dansoft-ch/KaRadio/KaRadio-Factsheet-FirmwareNG-BT.docx

KaRadio – Firmware NG mit Bluetooth („Biennophone“)

Factsheet · Stand 07.11.2026 · Branch firmware-ng-bt (v2) · Repository dansoft-ch/KaRadio · am Gerät getestet

So funktioniert das System

- Ein Board: Der ESP32 WROVER mit eigener KaRadio32-Firmware (Release 2.4 R1 plus stationkeys.c und btspeaker.c) liest Tasten und Potis selbst aus und ist zusätzlich Bluetooth-Lautsprecher. Kein ESP32-S3 nötig. Netzteil ≥ 1 A, besser 2 A, am USB-Port des WROVER.
- Sendertasten 1–6: Rasttasten gegen GND, interner Pull-up, 40 ms entprellt. Taste n spielt Sender n−1 (wie cli.play). Der Sender wird gespeichert und nach dem Einschalten wieder gespielt.
- Bluetooth: Immer an und für Handys als „Biennophone“ sichtbar (A2DP, Koppeln ohne PIN), auch während das Radio spielt. Spielt das Handy, stoppt das Radio und nach ca. 1 s kommt der Handy-Ton. Pause länger als 15 s oder Handy getrennt: der letzte Sender spielt wieder. Eine Sendertaste trennt das Handy und spielt den Sender. WLAN bleibt an.
- Lautstärke-Poti: Stellt die Lautstärke 0–254 ein, bei Radio und Bluetooth. In den ersten 60 s nach dem Start gilt immer das Poti, danach ändert sich die Lautstärke nur beim Drehen.
- Ein/Aus-Knopf: Der Schalter steuert ein Reed-Relais (hartes Ein/Aus, ohne Firmware). Der Schleifer des Potis steuert Mute nach der Drehrichtung: ca. 10 % aufdrehen = Mute aus, ca. 10 % zudrehen = Mute an. Nach dem Einschalten ist Mute aus.
- Absturz und Start-Wächter: Nach einem Absturz startet der WROVER selbst neu. Ein Hardware-Watchdog startet neu, wenn KaRadio nicht innerhalb von 90 s „READY“ erreicht. WLAN: 3 Versuche, dann ein Neustart, erst danach AP-Modus.

Pinout ESP32 WROVER

GPIO | Bedienung | GPIO | Audio und System
GPIO 13 | Taste 1 → Sender 0 | GPIO 25 | MAX98357A LRC (grün)
GPIO 14 | Taste 2 → Sender 1 | GPIO 26 | MAX98357A BCLK (blau)
GPIO 27 | Taste 3 → Sender 2 | GPIO 22 | MAX98357A DIN (gelb)
GPIO 15 | Taste 4 → Sender 3 (Boot-Pin) | 5 V / GND | VIN (rot) / GND (schwarz)
GPIO 5 | Taste 5 → Sender 4 (Boot-Pin) | SPI 18/19/23, 32/33/34, 12 | VS1053 (nicht bestückt)
GPIO 2 | Taste 6 → Sender 5 (Boot-Pin) | GPIO 1 / 3 | USB (CH343): Flashen, Monitor
GPIO 39 (VN) | Lautstärke-Poti (Schleifer) | GPIO 35 | frei (nur Eingang, ADC1)
GPIO 36 (VP) | Mute-Poti (Schleifer) | GPIO 0 | BOOT-Taste, nicht verwenden
GPIO 21 | IR-Empfänger | GPIO 16, 17 | nicht verwenden (PSRAM)
GPIO 4 | Status-LED | – | Ein/Aus-Schalter → Reed-Relais

Hellblau = Tasten und Potis am WROVER. Mute-Poti an GPIO 36 (P_MUTE_POT = 36); ohne Poti braucht der Pin 100 kΩ nach 3,3 V oder P_MUTE_POT = 255. Potis: Enden an 3,3 V (nie 5 V) und GND, nur ADC1-Pins (32–39). Eingerastete Tasten beim Einschalten sind unkritisch; zum Flashen Taste 1 einrasten. Pins ändern ohne neue Firmware: standard_psram_dan_keys.csv anpassen (P_KEY0 … P_KEY5, P_VOL_POT, P_MUTE_POT; 255 = aus) und die .bin neu flashen.

Bauen und flashen

- Bauen: GitHub Actions baut bei jedem Push in firmware/ (ESP-IDF 3.3.6, Ka-Radio32 auf festem Commit + karadio.patch) und legt die .bin-Dateien in firmware/bin/ ab (holen mit git pull).
- Flashen: WROVER direkt an den PC (neues Board: Seriennummer 5C92044814, zuletzt COM3), dann firmware\flash.ps1 -Port COM3. Das Skript prüft die Seriennummer und bricht beim S3 ab. Sender, WLAN und Einstellungen bleiben erhalten.
- Adressen: 0x1000 bootloader.bin · 0x8000 partitions.bin · 0x10000 KaRadio32.bin · 0x3a2000 standard_psram_dan_keys.bin. otadata (0xd000) wird gelöscht. Neue Partitionstabelle: App-Partition 3,5 MB, dafür kein Web-Update (OTA) mehr.
- Test: Seriellen Monitor auf 115200 Baud. Beim Start: „btspeaker: sichtbar als Biennophone“ und „Start-Waechter aus (Neustart-Grund …)“. Handy spielt: „Bluetooth-Ton an“. Pause/Trennen/Sendertaste: „zurueck zum Radio“.
- Zurück: Ohne Bluetooth: Release firmware-ng-v1. Bluetooth über Taste 6 mit Neustart: Tag firmware-ng-bt-v1 (siehe VERSIONEN.md).

Grenzen

- Speicher: Bluetooth belegt intern fest rund 90 KB. Deshalb liegen WLAN- und Decoder-Puffer im PSRAM. Gemessen frei: Radio mit Bluetooth ca. 27 KB, Bluetooth-Ton ca. 32 KB, Radio mit verbundenem Handy ca. 18 KB.
- Ohne WLAN: KaRadio wartet beim Start auf das WLAN (oder geht in den AP-Modus). Erst danach sind Tasten, Potis und Bluetooth aktiv.
- Nur I2S: Bluetooth und Mute funktionieren nur mit I2S-Ausgang (MAX98357A), nicht mit VS1053.

Flashen mit dem Flash Download Tool

Espressif „Flash Download Tool“ (Windows) · gleiche Wirkung wie firmware\flash.ps1 · Dateien aus firmware\bin (nach git pull) oder aus einem Tag

Dateien und Adressen

Adresse | Datei | Inhalt
0x1000 | bootloader.bin | Bootloader (mit Start-Wächter)
0x8000 | partitions.bin | Partitionstabelle (App 3,5 MB, ohne OTA)
0xd000 | otadata_blank.bin | leert „otadata“, damit sicher die neue Firmware startet (8 KB, nur FF)
0x10000 | KaRadio32.bin | Firmware (KaRadio32 + Tasten, Potis, Bluetooth)
0x3a2000 | standard_psram_dan_keys.bin | Hardware-Konfiguration (Pins, aus der .csv)

Alle fünf Zeilen anhaken. Nur die Konfiguration geändert (z. B. Pins in der .csv)? Dann genügt die letzte Zeile. Nur die Firmware geändert? Dann genügen 0x10000 und 0xd000.

- Achtung 0x1D0000: Beim Original-KaRadio wurde KaRadio32.bin zusätzlich an 0x1D0000 geflasht (zweite App-Partition ota_1). Diese Zeile abwählen! Unsere App-Partition reicht von 0x10000 bis 0x390000; eine Datei an 0x1D0000 überschreibt mitten in der Firmware.

Einstellungen im Tool

- Start: ChipType ESP32, WorkMode Develop, LoadMode UART.
- SPI: SPI SPEED 40 MHz, SPI MODE DIO, „DoNotChgBin“ angehakt (Standard), damit das Tool den Kopf des Bootloaders nicht verändert.
- Port: COM-Port des WROVER (CH343, Seriennummer 5C92044814), BAUD 460800 oder 921600. Vorher in der Geräteverwaltung prüfen, dass nicht der ESP32-S3 (5CE5194172) dranhängt.
- ERASE: Löscht den ganzen Flash, also auch WLAN-Daten, Senderliste und Einstellungen. Nur für eine saubere Neuinstallation: zuerst ERASE, dann START mit allen Zeilen (otadata_blank.bin ist dann nicht nötig). Danach Gerät neu einrichten (AP „WifiKaRadio“, http://192.168.4.1). Einstellungen behalten: kein ERASE, dafür otadata_blank.bin an 0xd000.

Ablauf

- 1: WROVER direkt per USB an den PC; serieller Monitor (Arduino IDE) muss geschlossen sein. Zum Flashen Taste 1 einrasten.
- 2: Dateien und Adressen wie oben eintragen und anhaken, Einstellungen setzen.
- 3: START drücken. Das Tool setzt den WROVER selbst in den Flash-Modus. Klappt das nicht: BOOT-Taste halten, EN kurz drücken, BOOT loslassen.
- 4: Nach „FINISH“ startet der WROVER nicht automatisch neu: EN-Taste drücken oder kurz vom Strom trennen.
- 5: Test: serieller Monitor mit 115200 Baud. Erwartet: „btspeaker: sichtbar als Biennophone“, „READY“, danach spielt der letzte Sender.

Frühere Versionen

- Ohne Bluetooth: Release firmware-ng-v1 auf GitHub: dieselben Adressen; die alte Partitionstabelle kommt mit partitions.bin zurück.
- Bluetooth v1/v2: Tag firmware-ng-bt-v1 bzw. firmware-ng-bt-v2 auschecken (git switch --detach …), Dateien aus firmware\bin. otadata_blank.bin gibt es in diesen Tags noch nicht: die Datei aus dem aktuellen Branch nehmen (sie ist immer gleich).
