dansoft-ch/KaRadio/KaRadio-Factsheet.docx

KaRadio – Internetradio mit Tastenbedienung

Factsheet · Stand 05.11.2026 · Repository dansoft-ch/KaRadio

So funktioniert das System

- ESP32 WROVER (Radio): KaRadio32 holt den Stream über WLAN, dekodiert ihn und gibt ihn per I2S an den Verstärker MAX98357A aus. Senderliste und Einstellungen über das Webinterface.
- ESP32-S3 (Bedienteil): 6 Taster wählen Sender (cli.play("n")), ein Poti stellt die Lautstärke (cli.vol("0..254")). Die RGB-LED zeigt den Sender (Farbe: rot, grün, blau, gelb, cyan, magenta) und die Lautstärke (Helligkeit).
- Verbindung: USB-Kabel vom Port „USB“ des S3 (USB-Host) zum CH343 des WROVER, 115200 Baud, Textbefehle. Rückweg: Die Ausgabe des WROVER erscheint als [WROVER] … am Port „COM“ des S3.
- Start: Der S3 startet den WROVER per RTS neu und wartet auf „READY.“. Bei WLAN-Fehler, Absturz oder 30 s ohne READY startet er ihn erneut (max. 5×). Danach wird die Poti-Lautstärke gesendet. READY nach ca. 16 s.
- Strom: Netzteil (≥ 1 A, besser 2 A) nur am Port „COM“ des S3. Der S3 versorgt den WROVER über das USB-Kabel (Lötbrücke „USB-OTG“ geschlossen). Nie beide S3-Ports gleichzeitig anschließen.

Pinout

ESP32-S3 | Funktion | ESP32 WROVER | Funktion
GPIO 4 … 9 | Taste 1 … 6 (gegen GND, Pull-up) | GPIO 25 | MAX98357A LRC (grün)
GPIO 1 | Poti-Schleifer (Enden an 3,3 V / GND) | GPIO 26 | MAX98357A BCLK (blau)
RGB-LED (GPIO 48/38) | Sender + Lautstärke | GPIO 22 | MAX98357A DIN (gelb)
GPIO 19/20 – Port „USB“ | USB-Host zum WROVER, liefert 5 V | 5 V / GND | MAX98357A VIN (rot) / GND (schwarz)
GPIO 43 (TX0) – Port „COM“ | Strom, Flashen, Mitlesen (COM9) | GPIO 21 | IR-Empfänger
GPIO 44 (RX0) | frei | GPIO 4 | Status-LED
GPIO 26 – 37 | nicht verwenden (Flash/PSRAM) | GPIO 3 (RX0) | UART-Eingang (alternativ zu USB)
| | SPI 18/19/23, 32/33/34, 12 | VS1053 (optional, siehe Hinweis)

Hinweise: GPIO 25 und 26 nicht vertauschen, sonst kommt kein Ton. GAIN und SD am MAX98357A offen lassen; Lautsprecher an + und −, nicht an GND. Ist ein VS1053 angeschlossen, spielt KaRadio nur über ihn und nicht über I2S.

Idee: Steuerung per App

- Sofort, ohne Programmieren: Das Webinterface von KaRadio auf dem Handy als Verknüpfung auf den Startbildschirm legen.
- Eigene kleine App oder Kurzbefehle: KaRadio versteht einfache Web-Adressen, z. B. http://<radio-ip>/?play=3, /?volume=150, /?stop, /?start und /?infos (aktueller Titel). Damit lassen sich iOS-Kurzbefehle, Android-Widgets, eine Web-App oder Home Assistant bauen.
- Komfort-Variante über den S3: Der S3 bekommt einen kleinen Webserver (WLAN) oder Bluetooth LE. Die App spricht mit dem S3, der S3 schickt die Befehle wie bisher per USB. Vorteil: RGB-LED und Tasten bleiben im Gleichklang mit der App.
- Abgleich mit dem Poti: Ändert die App die Lautstärke, gilt diese, bis jemand am Poti dreht (der S3 sendet nur bei Änderung). Der S3 kann außerdem die Statuszeilen des WROVER auswerten und die LED auch bei App-Bedienung nachführen.
