dansoft-ch/KaRadio/archiv/KaRadio-Factsheet-FirmwareNG.docx

KaRadio – Firmware Next Generation

Factsheet · Stand 06.11.2026 · Branch firmware-ng · Repository dansoft-ch/KaRadio

So funktioniert das System

- Ein Board: Der ESP32 WROVER mit eigener KaRadio32-Firmware (Release 2.4 R1 plus Ergänzung stationkeys.c) liest Tasten und Poti selbst aus. Der ESP32-S3 und das USB-Kabel zwischen den Boards entfallen.
- Tasten: 6 Taster gegen GND, interner Pull-up, 40 ms entprellt. Taste n spielt Sender n (wie cli.play("n")). Der Sender wird gespeichert und nach dem Einschalten wieder gespielt.
- Poti: Stellt die Lautstärke 0–254 ein (wie cli.vol), gemessen alle 80 ms. In den ersten 60 s nach dem Start gilt immer das Poti. Danach ändert sich die Lautstärke nur beim Drehen, das Webinterface kann sie dazwischen ändern.
- Absturz: Stürzt KaRadio ab (z. B. bei „Try next AP“ nach dem Kaltstart), startet der WROVER selbst neu, statt im gdb stub hängen zu bleiben. Das hat bisher der S3 per RTS erledigt.
- Strom: Netzteil (≥ 1 A, besser 2 A) direkt am USB-Port des WROVER. Es versorgt WROVER, VS1053 und MAX98357A.

Pinout ESP32 WROVER

GPIO | Bedienung | GPIO | Audio und System
GPIO 13 | Taste 1 → Sender 0 | GPIO 25 | MAX98357A LRC (grün)
GPIO 14 | Taste 2 → Sender 1 | GPIO 26 | MAX98357A BCLK (blau)
GPIO 27 | Taste 3 → Sender 2 | GPIO 22 | MAX98357A DIN (gelb)
GPIO 15 | Taste 4 → Sender 3 (Boot-Pin) | 5 V / GND | MAX98357A VIN (rot) / GND (schwarz)
GPIO 5 | Taste 5 → Sender 4 (Boot-Pin) | SPI 18/19/23, 32/33/34, 12 | VS1053 (optional)
GPIO 2 | Taste 6 → Sender 5 (Boot-Pin) | GPIO 1 / 3 | TX0 / RX0 → USB (CH343): Flashen, Monitor, cli-Befehle
GPIO 39 (VN) | Poti-Schleifer (Enden an 3,3 V / GND) | GPIO 35, 36 | frei (nur Eingang, ADC1)
GPIO 21 | IR-Empfänger | GPIO 0 | BOOT-Taste, nicht verwenden
GPIO 4 | Status-LED | GPIO 16, 17 | nicht verwenden (PSRAM)

Hellblau = Tasten und Poti, neu am WROVER anzuschließen. Hinweise: Beim Einschalten keine Taste gedrückt halten (GPIO 2, 5 und 15 sind Boot-Pins). Poti nur an 3,3 V, nie an 5 V. Fürs Poti nur ADC1-Pins (32–39) verwenden, ADC2 geht bei aktivem WLAN nicht. GPIO 25 und 26 nicht vertauschen, sonst kommt kein Ton. Pins ändern ohne neue Firmware: standard_psram_dan_keys.csv anpassen (P_KEY0 … P_KEY5, P_VOL_POT; 255 = aus) und die .bin neu flashen.

Bauen und flashen

- Bauen: GitHub Actions baut bei jedem Push in firmware/ (ESP-IDF 3.3.6, Ka-Radio32 auf festem Commit + karadio.patch). Ergebnis: Artefakt karadio32-firmware.
- Flashen: WROVER direkt an den PC (zuletzt COM4), dann flash.ps1 -Port COM4. Das Skript prüft die Seriennummer (WROVER 5C92044868) und bricht beim S3 ab. Sender, WLAN und Einstellungen bleiben erhalten.
- Adressen: 0x1000 bootloader.bin · 0x8000 partitions.bin · 0x10000 KaRadio32.bin · 0x3a2000 standard_psram_dan_keys.bin. otadata (0xd000) wird gelöscht, damit die neue Firmware startet.
- Test: Seriellen Monitor auf 115200 Baud öffnen. Beim Start erscheint „stationkeys: Taste n an GPIO …“, beim Drücken „Taste n -> Sender n“ und beim Drehen am Poti „##CLI.VOL#“.
- Zurück: Original-KaRadio32.bin an 0x10000 und die alte standard_psram_dan.bin an 0x3a2000 flashen.
