dansoft-ch/KaRadio/docs/etikette/vorschau.png

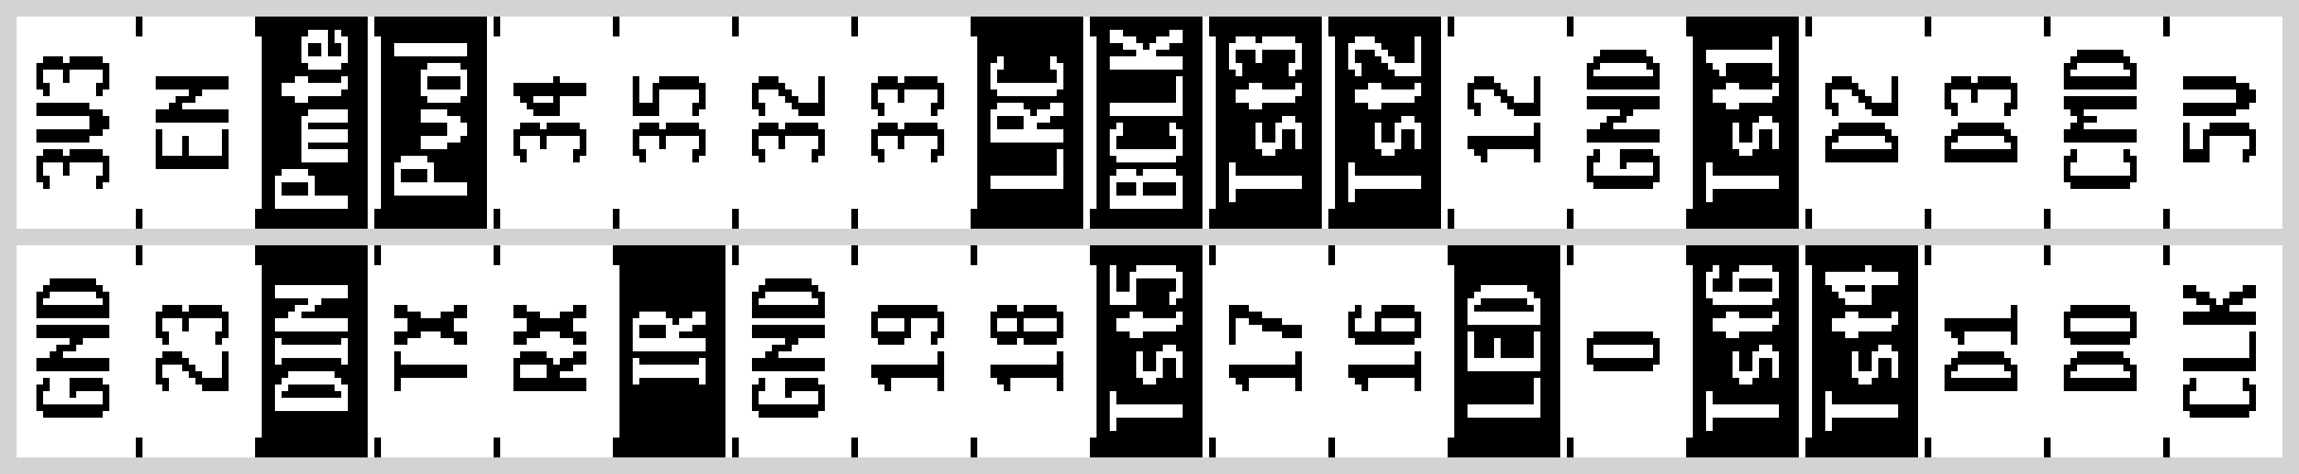
docs/etikette/vorschau.png
