dansoft-ch/KaRadio/TastaturLautstaerkeUART-S3/TastaturLautstaerkeUART-S3.ino

// Tastatur + Lautstärke-Poti -> KaRadio32 über USB (S3 als USB-Host)
// Version für ESP32-S3 (abgeleitet von TastaturLautstaerkeUART.ino für den Pro Mini)
//
// Tasten (GPIO 4-9, gegen GND) -> cli.play("n")
// Poti an GPIO 1 (0-3,3 V)     -> cli.vol("0..254")
//
// Ausgabe der Befehle:
//   1. USB-Port "USB" des S3 (USB-Host) -> USB-Port des WROVER-Boards.
//      Der S3 spricht dort direkt mit dem USB-Seriell-Chip des WROVER-Boards
//      (CP210x, CH340/CH341 oder CDC-Chip wie CH9102/CH343), 115200 Baud,
//      genau so, wie es vorher der serielle Monitor der Arduino-IDE am PC tat.
//   2. Zusätzlich wie bisher UART0 = USB-Port "COM" des S3 (und Pin TX0 = GPIO 43):
//      zum Mitlesen am PC. Dort erscheinen auch Meldungen zum USB-Host und die
//      Ausgabe des WROVER (über USB mitgelesen, Zeilen mit "[WROVER] ").
//
// Start-Überwachung (CDC-Chip): Befehle erst nach "READY." von KaRadio. Stürzt der
// WROVER ab, scheitert das WLAN beim Start oder kommt 30 s kein "READY", startet
// der S3 ihn per RTS neu (höchstens 5-mal).
//
// Verbindung:
//   S3-Port "USB" --(USB-Kabel, ggf. OTG-Adapter)--> USB-Port des WROVER-Boards
//   Der S3 muss über den Port "USB" 5 V an das WROVER-Board liefern. Bei vielen
//   S3-Boards ist das erst nach Schließen einer Lötbrücke ("USB-OTG", "IN-OUT")
//   der Fall. Alternativ das WROVER-Board selbst mit Strom versorgen.
//
// Hinweis zu DTR/RTS: Auf ESP32-Boards hängen daran EN und GPIO0 (Auto-Reset).
// Bei CDC-Chips (CH343 des WROVER) löst der S3 nach dem Anmelden einmal einen
// Reset per RTS aus (GPIO0 bleibt HIGH), weil der WROVER beim gemeinsamen
// Einschalten sonst nicht startet. Danach bleiben beide Leitungen inaktiv.
//
// ===================== PINOUT =====================
// ESP32-S3 (dieser Sketch):
//   GPIO 4 ... 9  Taste 1 ... 6 (andere Seite an GND, interner Pull-up)
//   GPIO 1        Poti-Schleifer (Poti-Enden an 3,3 V und GND)
//   RGB_BUILTIN   eingebaute RGB-LED (DevKitC-1: GPIO 48 bzw. 38)
//   GPIO 43 (TX0) Befehle zum Mitlesen (Port "COM"); optional per Draht an RX0/GPIO 3
//                 des WROVER, dann auch GND verbinden
//   GPIO 19/20    native USB (Port "USB") = USB-Host zum WROVER, liefert 5 V
//                 (Lötbrücke "USB-OTG" geschlossen)
//   Nicht verwenden: GPIO 26-32 (Flash), 33-37 (Octal-PSRAM)
//
// ESP32 WROVER (KaRadio32, aus standard_psram_dan.csv):
//   I2S-Verstärker MAX98357A:
//     GPIO 25 (P_I2S_LRCK) -> LRC   (Kabel grün)   Achtung: 25/26 nicht vertauschen,
//     GPIO 26 (P_I2S_BCLK) -> BCLK  (Kabel blau)   sonst kommt kein Ton
//     GPIO 22 (P_I2S_DATA) -> DIN   (Kabel gelb)
//     5 V                  -> VIN   (Kabel rot)
//     GND                  -> GND   (Kabel schwarz)
//     GAIN und SD offen; Lautsprecher an + und - (nicht an GND)
//   VS1053 (optional, SPI): MISO 19, MOSI 23, CLK 18, XCS 32, XDCS 33, DREQ 34, RST 12
//     Ist ein VS1053 angeschlossen, spielt KaRadio nur über ihn, nicht über I2S.
//   IR-Empfänger: GPIO 21     Status-LED: GPIO 4     UART-Eingang: RX0 = GPIO 3
//   USB: CH343 (VID 1A86 / PID 55D3) -> Kabel zum Port "USB" des S3
//
// Anzeige über die eingebaute RGB-LED:
//   - Farbe      = zuletzt gewählter Sender (6 Farben, vor der ersten Taste weiß)
//   - Helligkeit = Lautstärke (bei 0 fast aus, bei 254 hell)
//
// Arduino-IDE: "USB CDC On Boot" = Disabled (Standard), damit Serial0 = COM-Port.

#include "usb/usb_host.h"

const int schalterPins[6] = {4, 5, 6, 7, 8, 9};
int letzterZustand[6];

const int volPin = 1;       // Schleifer des Lautstärke-Potis (ADC1)

// Senderspeicher pro Taste (Taste 1 = Index 0 ... Taste 6 = Index 5).
// Falls Taste 1 den ersten Sender (Nr. 1) abrufen soll: auf 1 setzen.
const int STATION_OFFSET = 0;

const long UART_BAUD = 115200;     // KaRadio-Standard

// Helligkeit der RGB-LED (0..255) – die LED ist sehr hell, daher nicht voll ausfahren
const uint8_t LED_HELL_MIN = 2;     // bei Lautstärke 0 (Farbe gerade noch erkennbar)
const uint8_t LED_HELL_MAX = 120;   // bei Lautstärke 254

// Senderfarben (R, G, B) für Taste 1 ... 6
const uint8_t farbeOhneSender[3] = {255, 255, 255};   // weiß, bis eine Taste gedrückt wurde
int aktuellerSender = -1;                             // -1 = noch keine Taste
int angezeigteLautstaerke = 0;
const uint8_t senderFarben[6][3] = {
  {255,   0,   0},   // Taste 1: rot
  {  0, 255,   0},   // Taste 2: grün
  {  0,   0, 255},   // Taste 3: blau
  {255, 180,   0},   // Taste 4: gelb
  {  0, 255, 255},   // Taste 5: cyan
  {255,   0, 255},   // Taste 6: magenta
};

// Lautstärke
const int  ADC_MAX        = 4095;  // ESP32-S3: 12 Bit
const int  ADC_TOTZONE    = 60;    // Totzone an den Enden (ADC des S3 ist dort ungenau)
const int  VOL_MAX        = 254;   // KaRadio: 0..254
const int  VOL_HYSTERESE  = 2;     // Mindeständerung, bevor neu gesendet wird
const unsigned long VOL_INTERVALL = 80;     // ms zwischen ADC-Auswertungen
const unsigned long START_WARTEN  = 10000;  // ms, bis KaRadio gebootet hat (nur ohne Rückkanal)
int  letzteLautstaerke = -100;
unsigned long letzteVolZeit = 0;
unsigned long startZeit = 0;       // ab hier läuft START_WARTEN (neu bei USB-Verbindung)
bool startVolumeGesendet = false;

// Start-Überwachung des WROVER (nur bei CDC-Chip, dort gibt es Reset per RTS)
const unsigned long WROVER_START_MAX = 30000;  // ms bis "READY", sonst Neustart
const int WROVER_MAX_RESETS = 5;               // danach aufgeben

// ===================== USB-Host =====================

struct Befehl { char text[48]; };
QueueHandle_t befehlQueue;

static usb_host_client_handle_t usbClient;
static usb_device_handle_t usbGeraet = NULL;
static usb_transfer_t *ctrlXfer = NULL;
static usb_transfer_t *bulkXfer = NULL;
static uint8_t datenIntf = 0;
static uint8_t epOut = 0;
static uint8_t epIn = 0;
static usb_transfer_t *inXfer = NULL;
static volatile bool inBusy = false;
static char wroverZeile[160];
static int wroverLen = 0;
static volatile uint8_t neueAdresse = 0;
static volatile bool geraetWeg = false;
static volatile bool ctrlFertig = false;
static volatile bool bulkBusy = false;
static volatile bool usbBereit = false;
static volatile bool usbNeuVerbunden = false;
static int kommIntfAktiv = -1;               // CDC-Interface (für Reset), -1 = kein CDC
static volatile bool wroverBereit = false;   // KaRadio hat "READY" gemeldet
static volatile bool wroverHaengt = false;   // Absturz oder WLAN-Fehler beim Start
static volatile unsigned long resetZeit = 0;
static int resetAnzahl = 0;

// Zeile vom WROVER auswerten
void wroverZeileAuswerten(const char *z) {
  if (strstr(z, "READY.")) {
    wroverBereit = true;
    resetAnzahl = 0;
  } else if (strstr(z, "rst:0x")) {             // WROVER startet (neu)
    wroverBereit = false;
    resetZeit = millis();
  } else if (strstr(z, "Guru Meditation") || strstr(z, "gdb stub")) {
    wroverBereit = false;
    wroverHaengt = true;                        // bleibt im gdb stub stehen
  } else if (!wroverBereit && (strstr(z, "Wifi Disconnected") || strstr(z, "Try next AP"))) {
    wroverHaengt = true;                        // WLAN beim Start fehlgeschlagen
  }
}

void usbClientCallback(const usb_host_client_event_msg_t *msg, void *arg) {
  if (msg->event == USB_HOST_CLIENT_EVENT_NEW_DEV) {
    neueAdresse = msg->new_dev.address;
  } else if (msg->event == USB_HOST_CLIENT_EVENT_DEV_GONE) {
    geraetWeg = true;
  }
}

void ctrlCallback(usb_transfer_t *t) { ctrlFertig = true; }
void bulkCallback(usb_transfer_t *t) { bulkBusy = false; }

// Ausgabe des WROVER (Rückkanal) zeilenweise mit "[WROVER] " auf Serial0 weitergeben
void inCallback(usb_transfer_t *t) {
  if (t->status == USB_TRANSFER_STATUS_COMPLETED) {
    for (int i = 0; i < t->actual_num_bytes; i++) {
      char c = t->data_buffer[i];
      if (c == '\n' || wroverLen >= (int)sizeof(wroverZeile) - 1) {
        wroverZeile[wroverLen] = '\0';
        Serial0.printf("[WROVER] %s\r\n", wroverZeile);
        wroverZeileAuswerten(wroverZeile);
        wroverLen = 0;
      } else if (c != '\r') {
        wroverZeile[wroverLen++] = c;
      }
    }
  }
  inBusy = false;
}

// Control-Transfer an Endpunkt 0, wartet auf das Ende.
bool steuerTransfer(uint8_t reqType, uint8_t req, uint16_t value, uint16_t index,
                    uint8_t *daten, uint16_t laenge) {
  usb_setup_packet_t *s = (usb_setup_packet_t *)ctrlXfer->data_buffer;
  s->bmRequestType = reqType;
  s->bRequest = req;
  s->wValue = value;
  s->wIndex = index;
  s->wLength = laenge;
  bool rein = reqType & 0x80;
  if (daten && !rein) memcpy(ctrlXfer->data_buffer + sizeof(usb_setup_packet_t), daten, laenge);
  ctrlXfer->num_bytes = sizeof(usb_setup_packet_t) + laenge;
  ctrlXfer->device_handle = usbGeraet;
  ctrlXfer->bEndpointAddress = 0;
  ctrlXfer->callback = ctrlCallback;
  ctrlXfer->context = NULL;
  ctrlXfer->timeout_ms = 1000;

  ctrlFertig = false;
  if (usb_host_transfer_submit_control(usbClient, ctrlXfer) != ESP_OK) return false;
  while (!ctrlFertig) usb_host_client_handle_events(usbClient, pdMS_TO_TICKS(10));
  if (ctrlXfer->status != USB_TRANSFER_STATUS_COMPLETED) return false;
  if (daten && rein) memcpy(daten, ctrlXfer->data_buffer + sizeof(usb_setup_packet_t), laenge);
  return true;
}

// CDC-ACM (z. B. CH9102, CH343): SET_LINE_CODING 115200 8N1
bool einrichtenCdc(uint8_t kommIntf) {
  uint8_t lc[7] = {
    (uint8_t)(UART_BAUD), (uint8_t)(UART_BAUD >> 8), (uint8_t)(UART_BAUD >> 16), (uint8_t)(UART_BAUD >> 24),
    0, 0, 8   // 1 Stoppbit, keine Parität, 8 Datenbits
  };
  return steuerTransfer(0x21, 0x20, 0, kommIntf, lc, sizeof(lc));
}

// WROVER neu starten wie die Arduino-IDE (Auto-Reset-Schaltung):
// RTS aktiv + DTR inaktiv -> EN = LOW (Reset), GPIO 0 bleibt HIGH -> normaler Start.
// Nötig, weil der WROVER beim gemeinsamen Einschalten mit dem S3 nicht von selbst startet.
bool resetWroverCdc(uint8_t kommIntf) {
  if (!steuerTransfer(0x21, 0x22, 0x0002, kommIntf, NULL, 0)) return false;  // RTS an
  vTaskDelay(pdMS_TO_TICKS(100));
  return steuerTransfer(0x21, 0x22, 0x0000, kommIntf, NULL, 0);             // beide aus
}

// Silicon Labs CP210x
bool einrichtenCp210x(uint8_t intf) {
  uint8_t baud[4] = {
    (uint8_t)(UART_BAUD), (uint8_t)(UART_BAUD >> 8), (uint8_t)(UART_BAUD >> 16), (uint8_t)(UART_BAUD >> 24)
  };
  return steuerTransfer(0x41, 0x00, 0x0001, intf, NULL, 0)         // IFC_ENABLE
      && steuerTransfer(0x41, 0x1E, 0, intf, baud, 4)              // SET_BAUDRATE
      && steuerTransfer(0x41, 0x03, 0x0800, intf, NULL, 0);        // SET_LINE_CTL 8N1
}

// WCH CH340/CH341 (Ablauf wie im Linux-Treiber ch341.c)
bool einrichtenCh34x() {
  uint8_t version[2] = {0, 0};
  if (!steuerTransfer(0xC0, 0x5F, 0, 0, version, 2)) return false;   // Version lesen
  if (!steuerTransfer(0x40, 0xA1, 0, 0, NULL, 0)) return false;      // Init
  // Teiler für 115200 Baud: Prescaler 3, Divisor 0xCC, Bit 7 = sofort senden
  if (!steuerTransfer(0x40, 0x9A, 0x1312, 0xCC83, NULL, 0)) return false;
  if (version[0] >= 0x30) {
    // LCR: RX + TX an, 8 Datenbits, keine Parität, 1 Stoppbit
    if (!steuerTransfer(0x40, 0x9A, 0x2518, 0x00C3, NULL, 0)) return false;
  }
  return true;
}

void geraetEinrichten(uint8_t adresse) {
  if (usb_host_device_open(usbClient, adresse, &usbGeraet) != ESP_OK) {
    usbGeraet = NULL;
    Serial0.println("[USB] Geraet konnte nicht geoeffnet werden");
    return;
  }
  const usb_device_desc_t *dd;
  const usb_config_desc_t *cd;
  usb_host_get_device_descriptor(usbGeraet, &dd);
  usb_host_get_active_config_descriptor(usbGeraet, &cd);
  Serial0.printf("[USB] Geraet angeschlossen: VID %04X PID %04X\r\n", dd->idVendor, dd->idProduct);

  // Konfigurationsdeskriptor durchgehen: Bulk-OUT-Endpunkt und ggf. CDC-Interface suchen
  const uint8_t *p = (const uint8_t *)cd;
  int gesamt = cd->wTotalLength;
  int aktIntf = -1, aktAlt = 0, kommIntf = -1;
  epOut = 0;
  epIn = 0;
  for (int i = 0; i + 1 < gesamt && p[i] >= 2; i += p[i]) {
    if (p[i + 1] == USB_B_DESCRIPTOR_TYPE_INTERFACE) {
      aktIntf = p[i + 2];
      aktAlt = p[i + 3];
      if (p[i + 5] == 0x02 && kommIntf < 0) kommIntf = aktIntf;   // CDC Communication
    } else if (p[i + 1] == USB_B_DESCRIPTOR_TYPE_ENDPOINT && aktAlt == 0) {
      bool bulk = (p[i + 3] & 0x03) == 0x02;
      bool raus = !(p[i + 2] & 0x80);
      if (bulk && raus && epOut == 0) {
        epOut = p[i + 2];
        datenIntf = aktIntf;
      } else if (bulk && !raus && epIn == 0) {
        epIn = p[i + 2];
      }
    }
  }
  if (epOut == 0) {
    Serial0.println("[USB] Kein Bulk-OUT-Endpunkt gefunden - kein USB-Seriell-Chip?");
    usb_host_device_close(usbClient, usbGeraet);
    usbGeraet = NULL;
    return;
  }
  if (usb_host_interface_claim(usbClient, usbGeraet, datenIntf, 0) != ESP_OK) {
    Serial0.println("[USB] Interface konnte nicht belegt werden");
    usb_host_device_close(usbClient, usbGeraet);
    usbGeraet = NULL;
    return;
  }

  bool ok;
  const char *typ;
  if (kommIntf >= 0) {
    typ = "CDC-ACM";
    ok = einrichtenCdc(kommIntf);
    kommIntfAktiv = kommIntf;
    wroverBereit = false;
    wroverHaengt = false;
    resetAnzahl = 0;
    Serial0.printf("[USB] Reset WROVER per RTS: %s\r\n", resetWroverCdc(kommIntf) ? "ok" : "FEHLGESCHLAGEN");
    resetZeit = millis();
  } else if (dd->idVendor == 0x10C4) {
    typ = "CP210x";
    ok = einrichtenCp210x(datenIntf);
  } else if (dd->idVendor == 0x1A86) {
    typ = "CH34x";
    ok = einrichtenCh34x();
  } else {
    typ = "unbekannt (Daten werden ohne Einrichtung gesendet)";
    ok = true;
  }
  Serial0.printf("[USB] Chip: %s, Einrichtung %s\r\n", typ, ok ? "ok" : "FEHLGESCHLAGEN");

  usbBereit = true;          // auch bei Fehler versuchen zu senden
  usbNeuVerbunden = true;
}

void geraetSchliessen() {
  if (usbGeraet) {
    usb_host_interface_release(usbClient, usbGeraet, datenIntf);
    usb_host_device_close(usbClient, usbGeraet);
    usbGeraet = NULL;
    kommIntfAktiv = -1;
    wroverBereit = false;
    Serial0.println("[USB] Geraet getrennt");
  }
}

// Verwaltet den USB-Host (Treiber-Ereignisse)
void usbLibTask(void *arg) {
  while (true) {
    uint32_t flags;
    usb_host_lib_handle_events(portMAX_DELAY, &flags);
  }
}

// Unser USB-Client: Gerät einrichten und Befehle senden
void usbClientTask(void *arg) {
  Befehl b;
  while (true) {
    usb_host_client_handle_events(usbClient, pdMS_TO_TICKS(5));

    if (geraetWeg) {
      usbBereit = false;
      if (!bulkBusy && !inBusy) {   // laufende Transfers erst zu Ende kommen lassen
        geraetWeg = false;
        geraetSchliessen();
      }
      continue;
    }

    if (neueAdresse != 0 && usbGeraet == NULL) {
      uint8_t a = neueAdresse;
      neueAdresse = 0;
      geraetEinrichten(a);
    }

    // Start-Überwachung: Absturz, WLAN-Fehler oder kein "READY" -> WROVER neu starten
    if (usbBereit && kommIntfAktiv >= 0 && resetAnzahl < WROVER_MAX_RESETS) {
      bool zeitUm = !wroverBereit && (millis() - resetZeit > WROVER_START_MAX);
      if (wroverHaengt || zeitUm) {
        resetAnzahl++;
        Serial0.printf("[USB] WROVER %s -> Neustart per RTS (%d/%d)\r\n",
                       wroverHaengt ? "abgestuerzt / kein WLAN" : "meldet kein READY",
                       resetAnzahl, WROVER_MAX_RESETS);
        wroverHaengt = false;
        wroverBereit = false;
        resetWroverCdc(kommIntfAktiv);
        resetZeit = millis();
      }
    }

    // Rückkanal: ständig einen IN-Transfer offen halten
    if (usbBereit && epIn && !inBusy) {
      inXfer->num_bytes = 64;
      inXfer->device_handle = usbGeraet;
      inXfer->bEndpointAddress = epIn;
      inXfer->callback = inCallback;
      inXfer->context = NULL;
      inXfer->timeout_ms = 0;
      inBusy = true;
      if (usb_host_transfer_submit(inXfer) != ESP_OK) inBusy = false;
    }

    if (usbBereit && !bulkBusy && xQueueReceive(befehlQueue, &b, 0) == pdTRUE) {
      size_t n = strlen(b.text);
      memcpy(bulkXfer->data_buffer, b.text, n);
      bulkXfer->num_bytes = n;
      bulkXfer->device_handle = usbGeraet;
      bulkXfer->bEndpointAddress = epOut;
      bulkXfer->callback = bulkCallback;
      bulkXfer->context = NULL;
      bulkXfer->timeout_ms = 1000;
      bulkBusy = true;
      if (usb_host_transfer_submit(bulkXfer) != ESP_OK) bulkBusy = false;
    }
  }
}

// Enum-Filter: lässt jedes Gerät zu (Standardkonfiguration).
// Notwendig: Der Arduino-Core (3.3.x) ist mit CONFIG_USB_HOST_ENABLE_ENUM_FILTER_CALLBACK
// gebaut. Ohne diesen Callback bleibt die Anmeldung des Geräts hängen – der Port wird
// zwar aktiv, aber es kommt nie ein NEW_DEV-Ereignis (und keine Fehlermeldung).
bool usbEnumFilter(const usb_device_desc_t *dd, uint8_t *bConfigurationValue) {
  return true;
}

void usbHostStarten() {
  befehlQueue = xQueueCreate(16, sizeof(Befehl));

  usb_host_config_t hostCfg = {};
  hostCfg.skip_phy_setup = false;
  hostCfg.intr_flags = ESP_INTR_FLAG_LEVEL1;
  hostCfg.enum_filter_cb = usbEnumFilter;
  if (usb_host_install(&hostCfg) != ESP_OK) {
    Serial0.println("[USB] usb_host_install fehlgeschlagen");
    return;
  }
  xTaskCreatePinnedToCore(usbLibTask, "usbLib", 4096, NULL, 2, NULL, 0);

  usb_host_client_config_t clientCfg = {};
  clientCfg.is_synchronous = false;
  clientCfg.max_num_event_msg = 5;
  clientCfg.async.client_event_callback = usbClientCallback;
  clientCfg.async.callback_arg = NULL;
  if (usb_host_client_register(&clientCfg, &usbClient) != ESP_OK) {
    Serial0.println("[USB] usb_host_client_register fehlgeschlagen");
    return;
  }
  usb_host_transfer_alloc(64 + sizeof(usb_setup_packet_t), 0, &ctrlXfer);
  usb_host_transfer_alloc(64, 0, &bulkXfer);
  usb_host_transfer_alloc(64, 0, &inXfer);

  xTaskCreatePinnedToCore(usbClientTask, "usbClient", 4096, NULL, 3, NULL, 0);
  Serial0.println("[USB] Host gestartet, warte auf WROVER am Port \"USB\"");
}

// ===================== Befehle =====================

// Mit Rückkanal (CDC): erst nach "READY" von KaRadio. Sonst: feste Wartezeit.
bool wroverBereitFuerBefehle() {
  if (kommIntfAktiv >= 0) return wroverBereit;
  return millis() - startZeit > START_WARTEN;
}

void sendeBefehl(const String &befehl) {
  String zeile = befehl + "\r\n";
  Serial0.print(zeile);                     // COM-Port / GPIO 43 (Mitlesen)

  if (usbBereit && wroverBereitFuerBefehle()) {   // USB -> WROVER
    Befehl b;
    strncpy(b.text, zeile.c_str(), sizeof(b.text) - 1);
    b.text[sizeof(b.text) - 1] = '\0';
    xQueueSend(befehlQueue, &b, 0);
  }
}

void sendeStation(int nr) {
  sendeBefehl("cli.play(\"" + String(nr) + "\")");
}

void sendeLautstaerke(int vol) {
  sendeBefehl("cli.vol(\"" + String(vol) + "\")");
}

// ===================== LED =====================

void setzeRgb(uint8_t r, uint8_t g, uint8_t b) {
#ifdef RGB_BUILTIN
  #if ESP_ARDUINO_VERSION_MAJOR >= 3
    rgbLedWrite(RGB_BUILTIN, r, g, b);
  #else
    neopixelWrite(RGB_BUILTIN, r, g, b);
  #endif
#endif
}

// Farbe des Senders, Helligkeit nach Lautstärke.
// Quadratische Kennlinie, damit die Helligkeit gleichmäßig zunimmt.
void aktualisiereLed() {
  const uint8_t *farbe = (aktuellerSender < 0) ? farbeOhneSender
                                               : senderFarben[aktuellerSender];
  long v = angezeigteLautstaerke;
  long hell = LED_HELL_MIN + (LED_HELL_MAX - LED_HELL_MIN) * v * v / ((long)VOL_MAX * VOL_MAX);
  setzeRgb(farbe[0] * hell / 255, farbe[1] * hell / 255, farbe[2] * hell / 255);
}

void zeigeSender(int taste) {
  aktuellerSender = taste;
  aktualisiereLed();
}

void zeigeLautstaerke(int vol) {
  if (vol == angezeigteLautstaerke) return;
  angezeigteLautstaerke = vol;
  aktualisiereLed();
}

// ===================== Poti =====================

int leseLautstaerke() {
  long summe = 0;
  for (uint8_t i = 0; i < 16; i++) summe += analogRead(volPin);   // glätten
  int roh = summe / 16;                                            // 0..4095
  roh = constrain(roh, ADC_TOTZONE, ADC_MAX - ADC_TOTZONE);
  return map(roh, ADC_TOTZONE, ADC_MAX - ADC_TOTZONE, 0, VOL_MAX);
}

void pruefeLautstaerke() {
  if (millis() - letzteVolZeit < VOL_INTERVALL) return;
  letzteVolZeit = millis();

  int vol = leseLautstaerke();
  bool aenderung = abs(vol - letzteLautstaerke) >= VOL_HYSTERESE;
  bool endanschlag = (vol != letzteLautstaerke) && (vol == 0 || vol == VOL_MAX);

  if (aenderung || endanschlag) {
    sendeLautstaerke(vol);
    zeigeLautstaerke(vol);
    letzteLautstaerke = vol;
  }
}

// ===================== Setup / Loop =====================

void setup() {
  Serial0.begin(UART_BAUD);   // UART0: COM-Port + GPIO 43 (Mitlesen)

  analogReadResolution(12);
  angezeigteLautstaerke = leseLautstaerke();
  aktualisiereLed();

  for (int i = 0; i < 6; i++) {
    pinMode(schalterPins[i], INPUT_PULLUP);
    letzterZustand[i] = digitalRead(schalterPins[i]);
  }

  usbHostStarten();
}

void loop() {
  // WROVER (neu) per USB verbunden: Lautstärke nach dessen Boot erneut senden
  if (usbNeuVerbunden) {
    usbNeuVerbunden = false;
    startZeit = millis();
    startVolumeGesendet = false;
  }

  // Lautstärke: erst senden, wenn KaRadio bereit ist (nach jedem Neustart erneut),
  // sonst geht der Wert verloren. Die LED zeigt die Poti-Stellung aber schon vorher an.
  if (!wroverBereitFuerBefehle()) {
    startVolumeGesendet = false;
    zeigeLautstaerke(leseLautstaerke());
  } else if (!startVolumeGesendet) {
    letzteLautstaerke = leseLautstaerke();
    sendeLautstaerke(letzteLautstaerke);
    zeigeLautstaerke(letzteLautstaerke);
    startVolumeGesendet = true;
  } else {
    pruefeLautstaerke();
  }

  // Tasten
  for (int i = 0; i < 6; i++) {
    int aktuell = digitalRead(schalterPins[i]);

    if (aktuell != letzterZustand[i]) {
      delay(50);                       // Entprellen
      aktuell = digitalRead(schalterPins[i]);

      // nur senden, wenn der Kontakt neu geschlossen wurde
      if (aktuell == LOW && letzterZustand[i] == HIGH) {
        sendeStation(i + STATION_OFFSET);
        zeigeSender(i);                // Farbe bleibt bis zur nächsten Taste
      }
      letzterZustand[i] = aktuell;
    }
  }
}
