dansoft-ch/KaRadio/firmware/stationkeys.h

#ifndef __STATIONKEYS_H__
#define __STATIONKEYS_H__

// Startet die Abfrage der Sendertasten und des Lautstärke-Potis
// (nur wenn P_KEY0..5 / P_VOL_POT in der Hardware-Partition stehen).
void stationKeysStart(void);

#endif
