dansoft-ch/KaRadio/(commit log)

2026-10-24 Code fuer Tastatur
    Arduino pro mini
2026-10-24 Update TastaturCode.ino
    Komplett überarbeitet durch Claude. Blincken der LED zum Feedback der Tasten visualisieren.
2026-10-24 Update standard_psram.csv
    IR an Pin21 aktiviert und Senderzuweisung eingebaut
    [standard_psram.csv]
2026-10-25 Create TastaturLautstaerke
    Neu werden die Tasten und die Lautstäre über die Serielle Schnittstelle übertragen.
    Die Lautstärke wird analog über eine Poti und allfälligen rail to rail Opamp-Verstärker (MCP6002 oder MCP6022) vorgegeben.
2026-10-25 Create TestUART.ino
    gibt einen text auf die UART zum sehen, ob die überhaupt reagiert
2026-10-25 Rename TastaturLautstaerke.ino to TastaturLautstaerkeUART.ino
    Hat leider nie funktioniert. Die UART (RX ESP32) nimmt die Signale nicht an.
2026-10-25 IR Simulator nun auch mit Lautstärke
    Da es offenbar mit der UART nicht geht.
2026-10-25 Update TastaturLautstaerkeIR.ino
    Reaktion Lautstärke schneller gemacht (Filter angepasst)
2026-10-26 Update TastaturLautstaerkeIR.ino
    VOL_STUFEN: 20 statt 30, also weniger Schritte bis zum Ziel.
    MIN_ABSTAND_MS: 10 statt 40 ms Pause zwischen den Telegrammen. Das ist die größte Bremse.
    HYSTERESE: 0,2 statt 0,3.
2026-10-26 Update TastaturLautstaerkeIR.ino
    Ursache: Der Sketch ist von 40 Lautstärkestufen ausgegangen. KaRadio ändert die Lautstärke aber pro IR-Befehl um 5 im Bereich 0…254 und begrenzt an den Enden, es braucht also 51 Befehle von ganz leise bis ganz laut.
    Am oberen Anschlag hat der Sketch dann die 6 Zusatzbefehle gesendet, ohne dass KaRadio schon am Maximum war. Das Radio stand danach 6 Schritte höher, als der Sketch mitgezählt hat. Bei jedem weiteren Vollausschlag kam ein Versatz dazu, bis das Radio einmal wirklich begrenzt hat. Deshalb war das Maximum mal 230, mal 254. Das Minimum war stabil, weil dort KaRadio sauber auf 0 begrenzt.
    Änderungen:
    Der Sketch bildet die KaRadio-Lauts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
2026-10-30 Update TastaturLautstaerkeIR.ino
    Kommentar ergänzt. Getestet und funktioniert in Abhängigkeit vom Board!
2026-11-05 S3-Version des Tastatur/Lautstärke-Sketches und CLAUDE.md
    - TastaturLautstaerkeUART-S3.ino: Serial1 (TX GPIO 17), 12-Bit-ADC, RGB-LED
    - CLAUDE.md: Aufbau mit WROVER (KaRadio) und S3 (Tastatur/Lautstärke)
2026-11-05 S3: Ausgabe über UART0 (COM-Port), RGB-LED zeigt Sender und Lautstärke
    - Befehle über Serial0 (TX GPIO 43 / zweiter USB-Port)
    - RGB-LED: Farbe = Sender (6 Farben), Helligkeit = Lautstärke
    - CLAUDE.md angepasst
2026-11-05 S3 als USB-Host: Befehle per USB-Kabel an den WROVER
    Der Port USB des S3 arbeitet als USB-Host und sendet cli.play/cli.vol
    mit 115200 Baud an den USB-Seriell-Chip des WROVER-Boards (CP210x,
    CH340/CH341, CDC-ACM wie CH9102). DTR/RTS bleiben unberuehrt.
    Sketch liegt jetzt im gleichnamigen Ordner (fuer arduino-cli).
2026-11-05 S3 USB-Host: Enum-Filter setzen, damit der WROVER erkannt wird
    Der Arduino-Core (3.3.x, IDF 5.5) ist mit CONFIG_USB_HOST_ENABLE_ENUM_FILTER_CALLBACK
    gebaut; ohne Callback blieb die Anmeldung haengen. CLAUDE.md um Hinweise
    dazu und zum CH343 des WROVER ergaenzt.
2026-11-05 S3: WROVER per RTS starten, Ausgabe mitlesen, auf READY warten
    - Reset per RTS nach dem USB-Anmelden (WROVER startet beim Einschalten nicht von selbst)
    - Rückkanal: WROVER-Ausgabe über USB mitlesen, als [WROVER] auf COM9
    - Befehle erst nach READY. von KaRadio; Poti-Lautstärke nach jedem Start neu senden
    - Bei Absturz, WLAN-Fehler vor READY oder 30 s ohne READY: Neustart (max. 5x)
    - CLAUDE.md: Start-Ablauf dokumentiert
    [TastaturLautstaerkeUART-S3.ino]
2026-11-05 Pinout fuer S3 und WROVER im Sketch, Factsheet als Word
    - Sketch-Kopf: vollstaendiges Pinout beider Boards (Tasten, Poti, LED, USB,
    I2S-Verstaerker, VS1053, IR) inkl. Hinweis GPIO 25/26 nicht vertauschen
    - KaRadio-Factsheet.docx: eine A4-Seite mit Funktionsweise, Pinout und
    Ideen zur App-Steuerung
2026-11-06 Firmware NG: Sendertasten und Lautstaerke-Poti direkt im KaRadio32
    Neue Datei stationkeys.c liest bis zu 6 Taster (P_KEY0..5) und ein Poti
    (P_VOL_POT) aus der Hardware-Partition. Der S3 wird damit nicht mehr
    gebraucht. Panic-Handler auf Neustart statt gdb stub gestellt.
    GitHub Actions baut KaRadio32 2.4 R1 mit ESP-IDF 3.3.6.
    [standard_psram_dan_keys.csv]
2026-11-06 Firmware NG: Meldungen per printf, da KaRadio nur Warnungen loggt
2026-11-06 Firmware NG: Factsheet, neues WROVER-Board dokumentiert
    - KaRadio-Factsheet-FirmwareNG.docx: eine A4-Seite mit Funktion,
    Pinout WROVER, Bauen und Flashen
    - flash.ps1 kennt die Seriennummer des neuen WROVER (5C92044814)
    - CLAUDE.md: neues Board an COM10, Testergebnis nach dem Flashen
2026-11-07 Firmware NG BT: Bluetooth-Lautsprecher (Taste 6) und Mute-Poti
    - btspeaker.c: A2DP-Sink Biennophone, Ton ueber KaRadio-Renderer (I2S)
    - stationkeys.c: Bluetooth-Rasttaste (P_KEY_BT), Mute-Poti nach Drehrichtung (P_MUTE_POT)
    - karadio.patch: Mute im Renderer, Radio im BT-Betrieb gesperrt, BT in sdkconfig,
    ota_0 auf 3,5 MB (ota_1 entfernt, uebrige Partitionen unveraendert)
    [standard_psram_dan_keys.csv]
2026-11-07 Firmware NG BT: Anleitung fuer Bluetooth, Mute-Poti und Partitionen
2026-11-07 Firmware NG BT: Start-Waechter in der Anleitung
2026-11-07 Firmware NG BT: BT-Speicher im Radio-Betrieb frei, Wechsel per Neustart, WLAN-Wiederholversuche
    - Beim Start entscheidet die Bluetooth-Taste: frei = BT-Speicher (ca. 56 KB intern) ans Radio
    - Wechsel Radio <-> Bluetooth ueber Neustart (Sender wird gespeichert, autostart an)
    - WLAN: dasselbe Netz 3x versuchen, dann einmal neu starten, erst danach AP-Modus
2026-11-07 Firmware NG BT: I2S im Bluetooth-Betrieb selbst einrichten (Absturz behoben), Mute-Poti vorerst aus
    Ohne Radio-Decoder war kein I2S-Treiber installiert, i2s_write stuerzte ab (LoadProhibited).
    GPIO 36 schwebt ohne Poti/Widerstand und loeste Mute aus: P_MUTE_POT=255 bis Hardware fertig.
    [standard_psram_dan_keys.csv]
2026-11-07 Firmware NG BT v2: Bluetooth immer an, automatische Umschaltung, Taste 6 wieder Sender 6
    - btspeaker: Stack beim Start, immer sichtbar; Handy spielt -> Radio stoppt, I2S selbst einrichten;
    Handy getrennt oder 15 s Pause -> I2S abbauen, letzter Sender spielt
    - Sendertaste im BT-Betrieb trennt das Handy und spielt Radio
    - WLAN: feste RX-Puffer 14->10, TX 10->6 (Speicher fuer BT + Radio)
    [standard_psram_dan_keys.csv]
2026-11-07 AAC-Decoder: Puffer ohne DMA (PSRAM), 20 KB mehr interner Speicher
2026-11-07 Doku und Factsheet fuer v2: Bluetooth immer an, automatische Umschaltung
2026-11-07 Mute-Poti an GPIO 36 eingeschaltet (Poti angeschlossen)
    [standard_psram_dan_keys.csv]
2026-11-07 README mit Architektur-Bild, Entwicklungsgeschichte und Flash-Anleitung
2026-11-07 README mit Architektur-Bild, Entwicklungsgeschichte und Flash-Anleitung (aus firmware-ng-bt)
2026-11-08 Bluetooth: nur bei hoerbarem Ton aufs Handy umschalten
    Behebt den Fehler in firmware-ng-bt-v2: Blieb das Handy nach einer Pause
    verbunden, meldete es fuer Benachrichtigungen oder Stille "spielt" und das
    Radio setzte jedes Mal ca. 30 s aus.
    Neu: Umschalten erst nach 1,5 s hoerbarem Ton (checkAudible), zurueck zum
    Radio nur beim Trennen oder per Sendertaste. Der 15-s-Ruecksprung bei Pause
    ist entfernt. Doku: Fehler von v2 und Aenderung in VERSIONEN.md.
2026-11-11 Etiketten-Vorlage (P-touch 6 mm) mit Pinout des ESP32-WROVER
    Skript docs/etikette/etikette.ps1 erzeugt je ein PNG (180 dpi, Raster 2,54 mm)
    fuer die linke und rechte Stiftleiste, mit Kuerzeln wie im Factsheet
    (Tst1..6, Pvol, Pmte, LRC/BCLK/DIN, IR, LED) und eigener fetter Pixelschrift.
